ELtime1285/ismeritel_Emcosti/измеритель плата/плата в реальности/Лицевая сторона.jpg

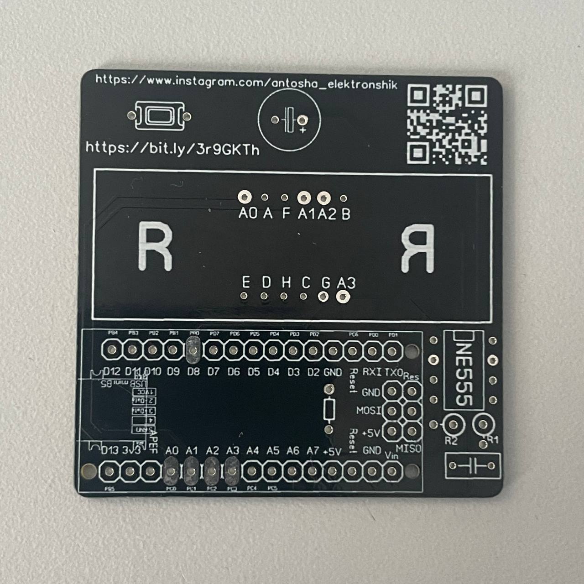
измеритель плата/плата в реальности/Лицевая сторона.jpg
