ELtime1285/ismeritel_Emcosti/измеритель плата/плата в реальности/Задняя сторона.jpg

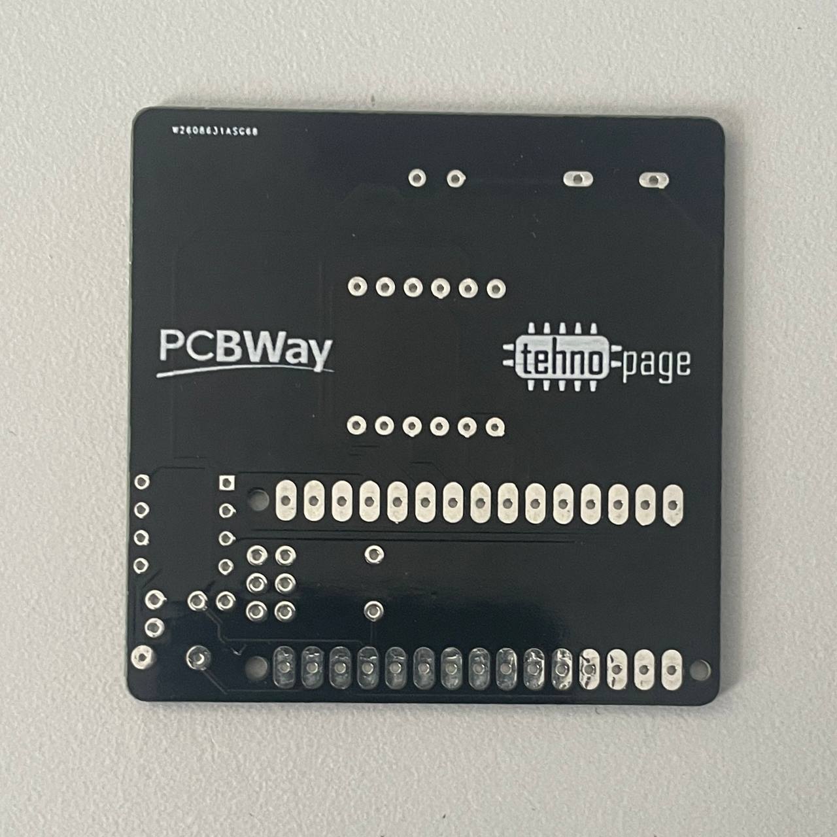
измеритель плата/плата в реальности/Задняя сторона.jpg
