ELtime1285/ismeritel_Emcosti/README.md

# ismeritel_Emcosti
Устройство, способное измерять ёмкость конденсаторов.
