ELtime1285/ismeritel_Emcosti/измеритель плата/JPGкартинка.JPG

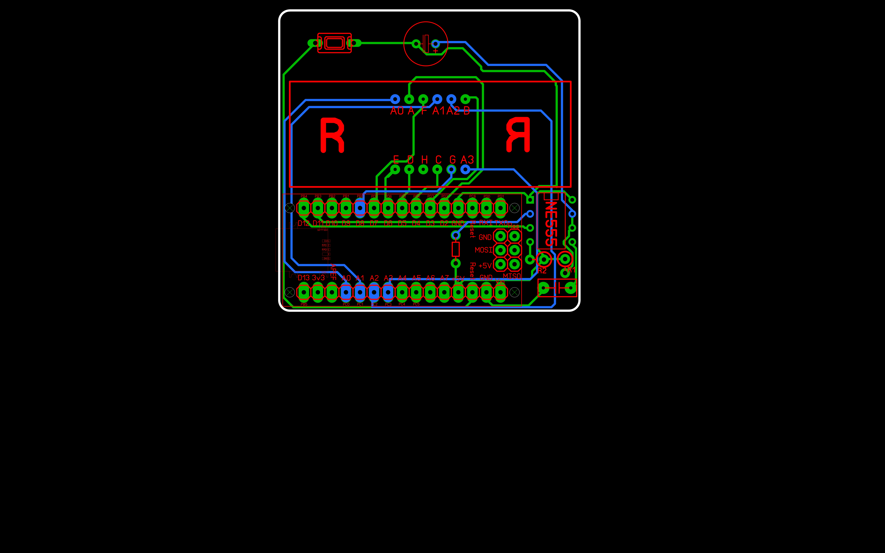
измеритель плата/JPGкартинка.JPG
