ELtime1285/ismeritel_Emcosti/3D модель корпуса/основной корпус/main.stl

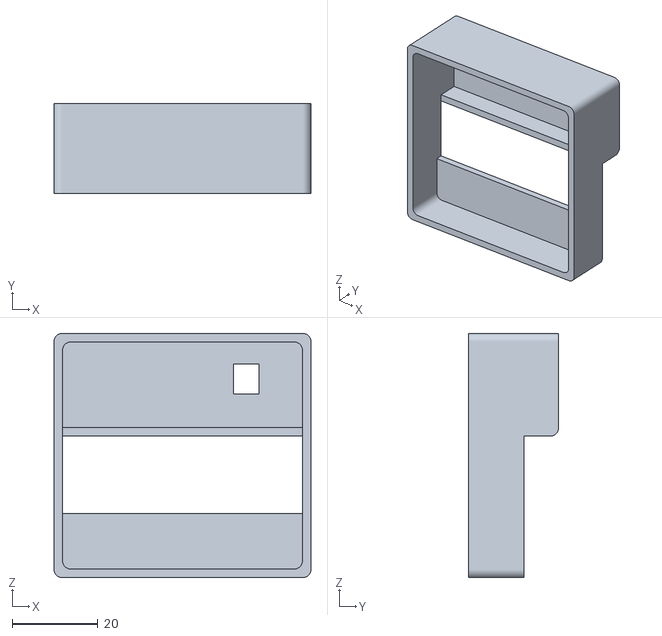
[picture p23: CAD file, 2023-04-06]
3D модель корпуса/основной корпус/main.stl
60.0 x 21.0 x 57.0
