ELtime1285/ismeritel_Emcosti/3D модель корпуса/крыжка/downtown.stl

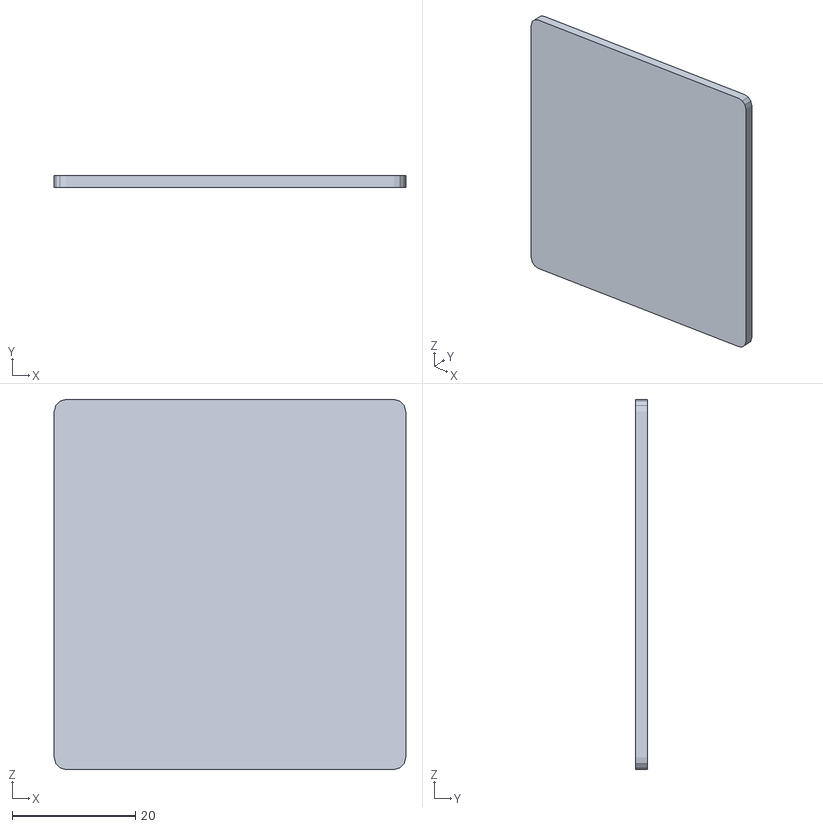
[picture p24: CAD file, 2023-04-06]
3D модель корпуса/крыжка/downtown.stl
57.0 x 2.00 x 60.0
