ELtime1285/ismeritel_Emcosti/(list of files, drawings)

Other design files:
измеритель плата/плата тестера ёмкости.lay6
Наглядная схема проекта исходники/бекап/Untitled Sketch 3.fzz
Наглядная схема проекта исходники/Наглядная Схема проекта.fzz
